cbm-instructions/das-team/src/Websites/images/Blockveranstaltung.png

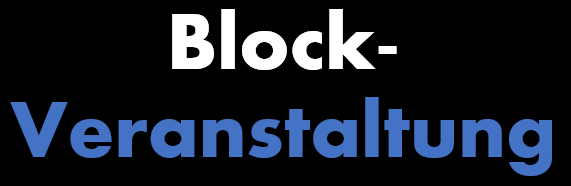
src/Websites/images/Blockveranstaltung.png
