cbm-instructions/das-team/src/Websites/images/bwlehrpool.jpg

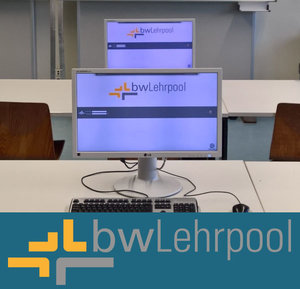
src/Websites/images/bwlehrpool.jpg
