cbm-instructions/das-team/src/Websites/images/ElektrotechnischesSeminar.jpg

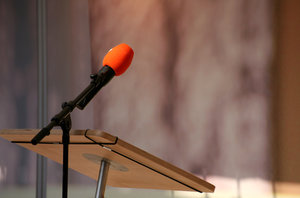
src/Websites/images/ElektrotechnischesSeminar.jpg
