cbm-instructions/das-team/src/Websites/images/gastVORTRAG.png

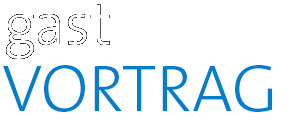
src/Websites/images/gastVORTRAG.png
