cbm-instructions/das-team/src/Websites/images/gastvotragE_Business.png

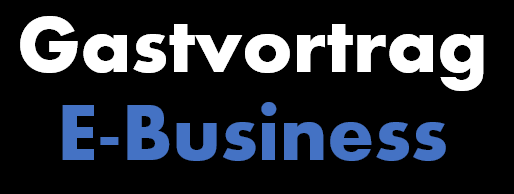
src/Websites/images/gastvotragE_Business.png
