cbm-instructions/das-team/src/Websites/images/iEXPO.png

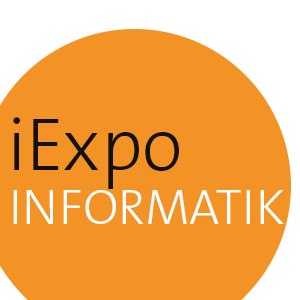
src/Websites/images/iEXPO.png
