cbm-instructions/das-team/src/Websites/images/infoVeranstaltung.png

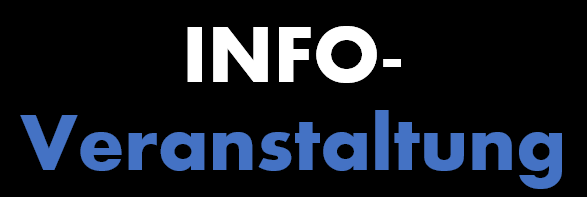
src/Websites/images/infoVeranstaltung.png
