cbm-instructions/das-team/src/Websites/images/Leiterplattenseminar.jpg

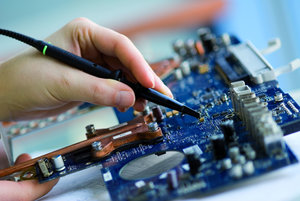
src/Websites/images/Leiterplattenseminar.jpg
