cbm-instructions/das-team/src/Websites/images/sozialeArbeitMitFluechtlingen.png

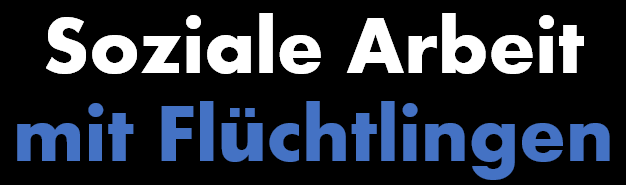
src/Websites/images/sozialeArbeitMitFluechtlingen.png
