cbm-instructions/das-team/images/StepByStep/Step4-3.png

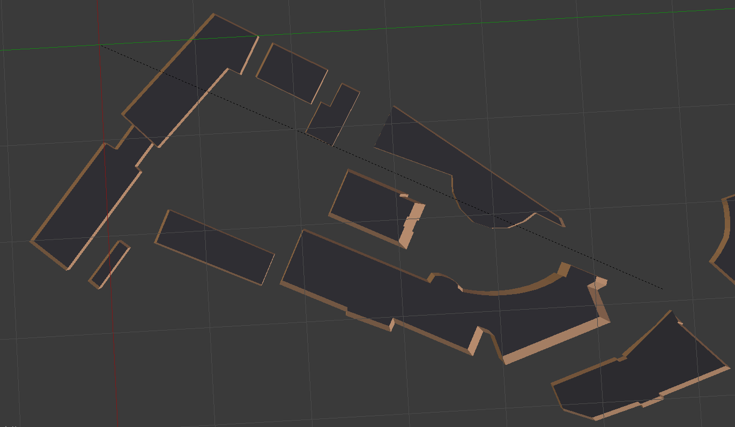
images/StepByStep/Step4-3.png
