cbm-instructions/das-team/images/StepByStep/Step4-5.png

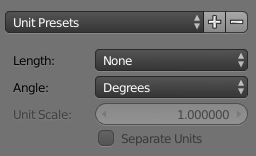
images/StepByStep/Step4-5.png
