cbm-instructions/das-team/images/StepByStep/Step4-7.png

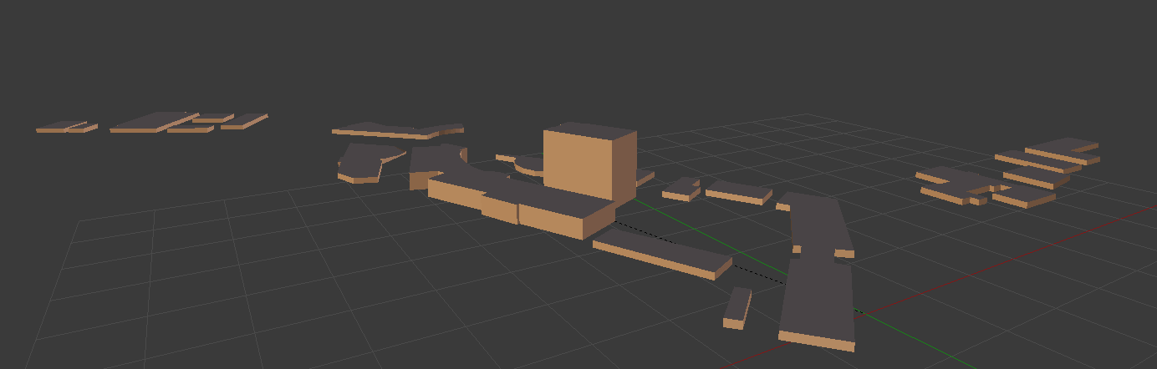
images/StepByStep/Step4-7.png
