cbm-instructions/das-team/images/StepByStep/Step4-8.png

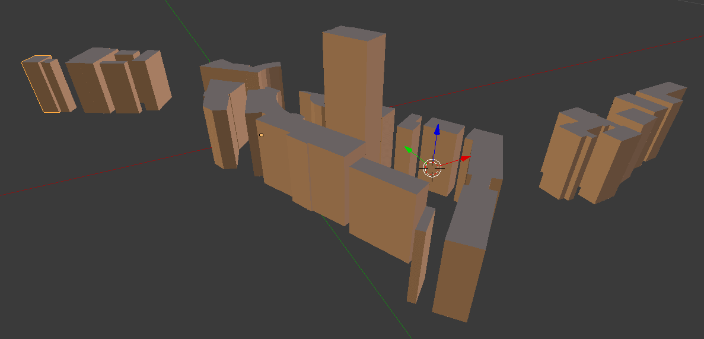
images/StepByStep/Step4-8.png
