cbm-instructions/das-team/images/StepByStep/Step4-9.png

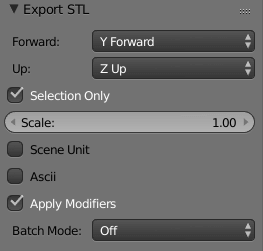
images/StepByStep/Step4-9.png
