cbm-instructions/das-team/src/Websites/images/building/A.jpg

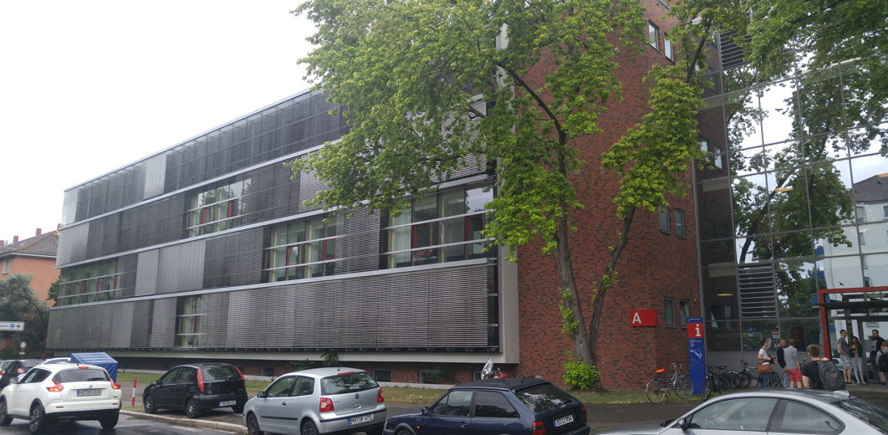
src/Websites/images/building/A.jpg
