cbm-instructions/das-team/src/Websites/images/building/B.jpg

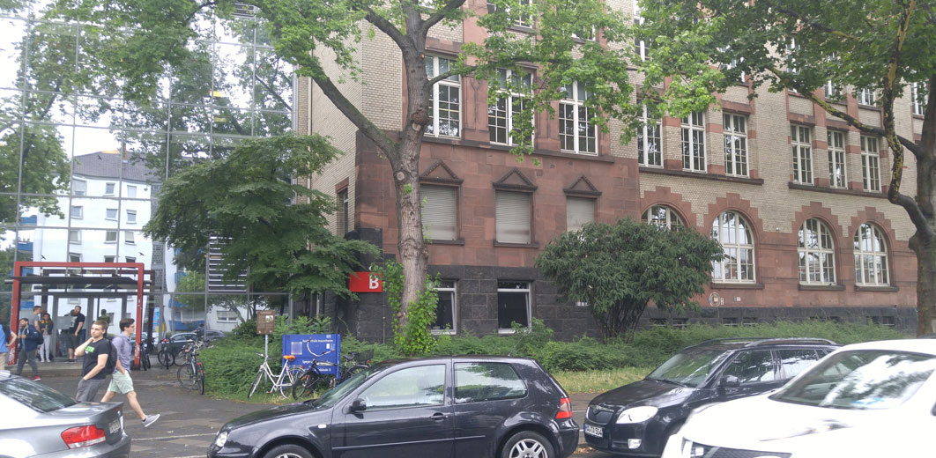
src/Websites/images/building/B.jpg
