cbm-instructions/das-team/src/Websites/images/building/C.jpg

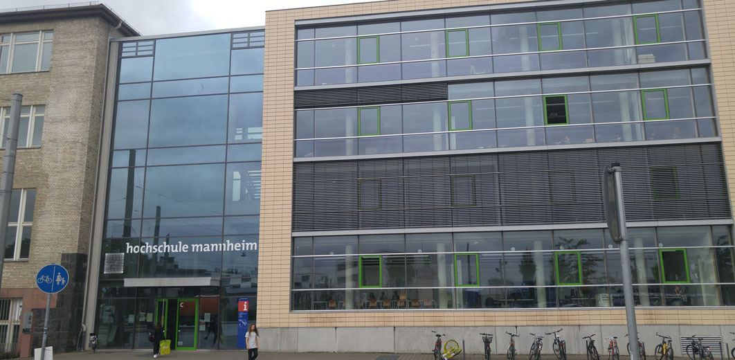
src/Websites/images/building/C.jpg
