cbm-instructions/das-team/src/Websites/images/building/E.jpg

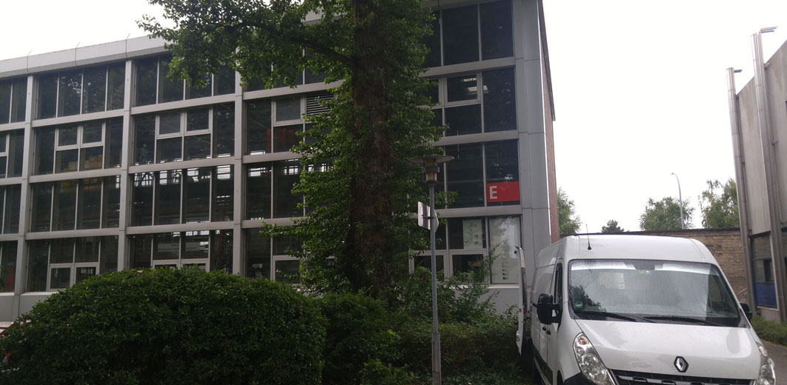
src/Websites/images/building/E.jpg
