cbm-instructions/das-team/src/Websites/images/building/F.jpg

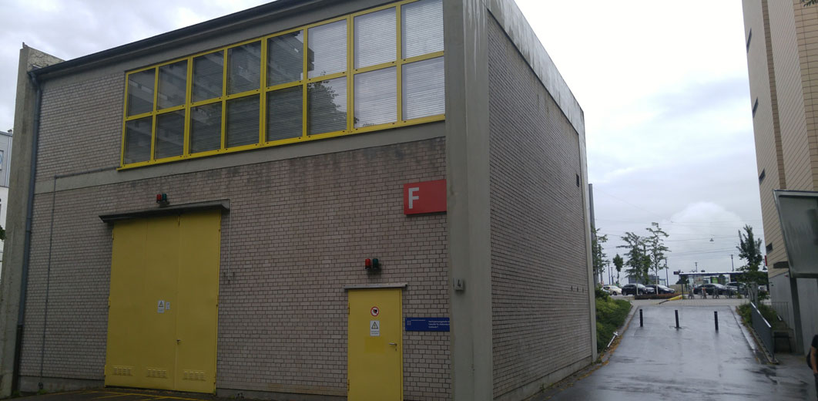
src/Websites/images/building/F.jpg
