cbm-instructions/das-team/src/Websites/images/building/G.jpg

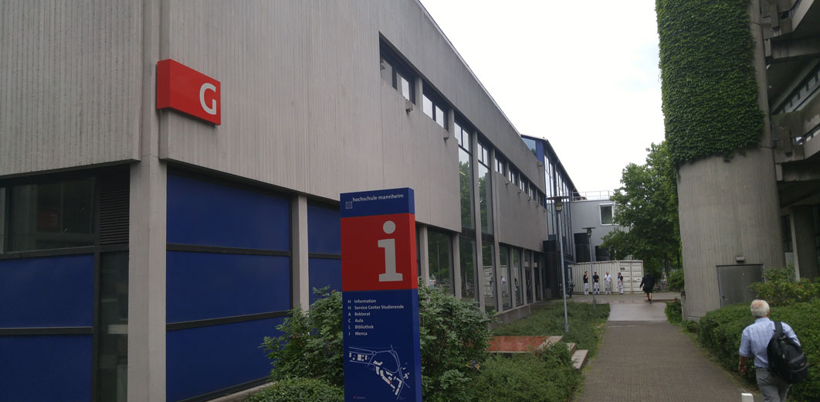
src/Websites/images/building/G.jpg
