cbm-instructions/das-team/src/Websites/images/building/H.jpg

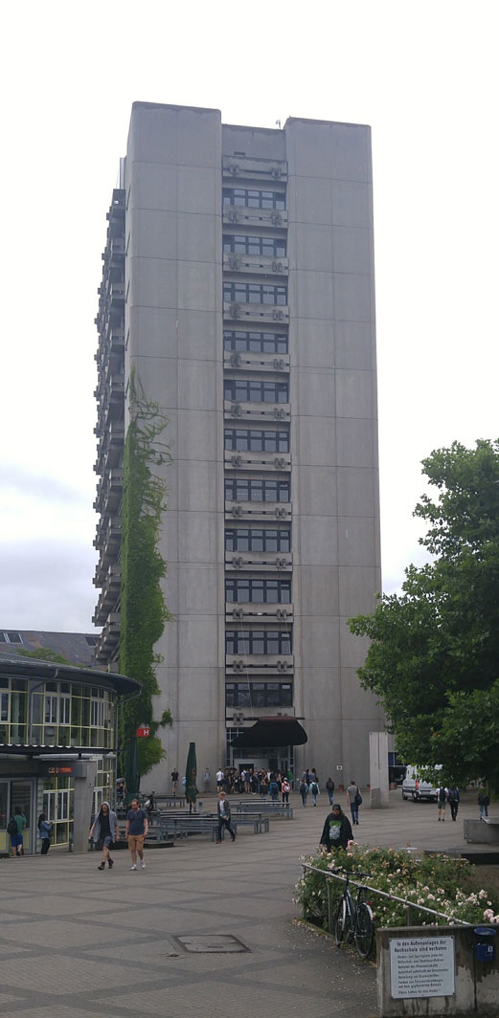
src/Websites/images/building/H.jpg
