cbm-instructions/das-team/src/Websites/images/building/J.jpg

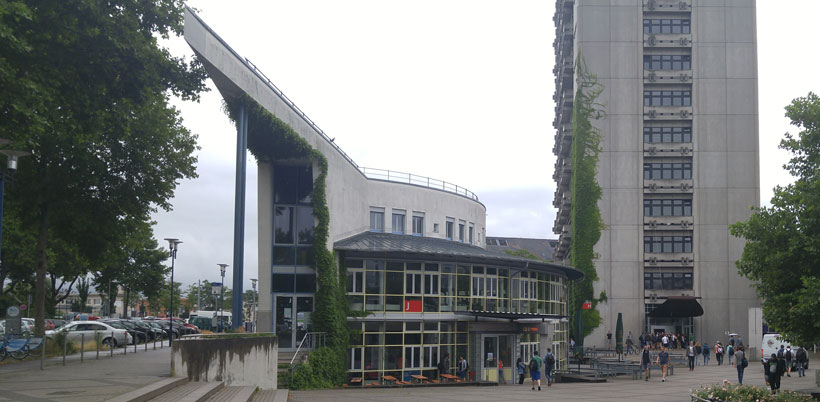
src/Websites/images/building/J.jpg
