cbm-instructions/das-team/src/Websites/images/building/K.jpg

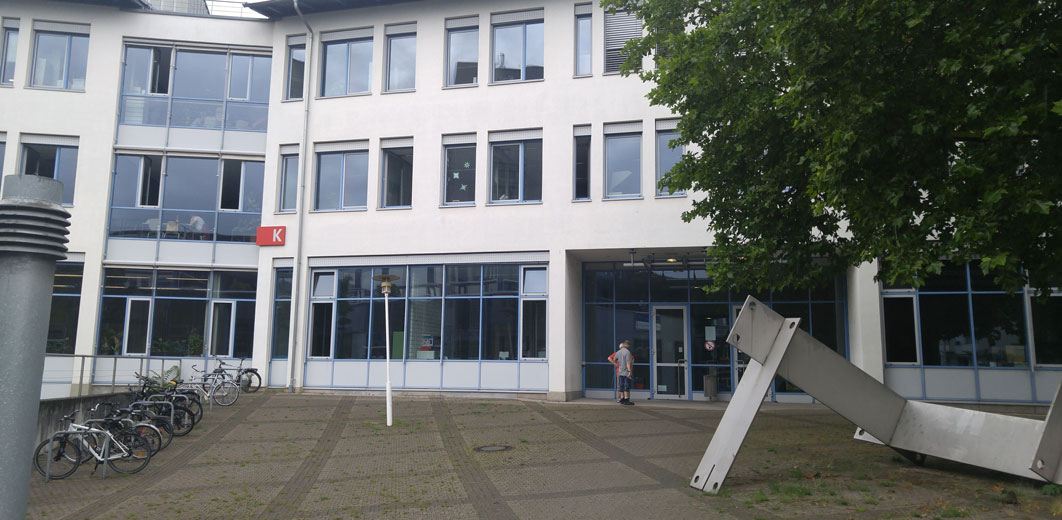
src/Websites/images/building/K.jpg
