cbm-instructions/das-team/src/Websites/images/building/L.jpg

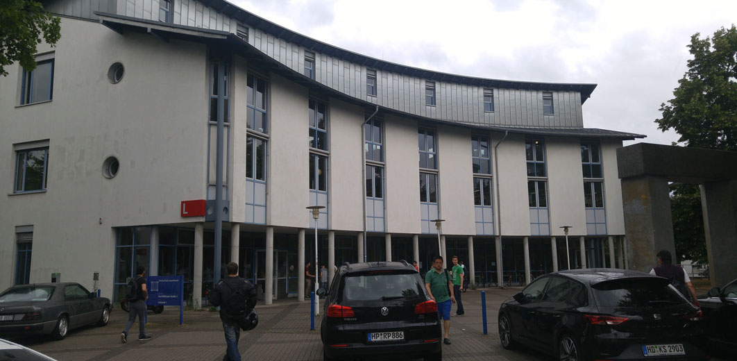
src/Websites/images/building/L.jpg
